denmanlab/electric_stim_gui/images/BRAINSBoard_Top_Profile_edited 4.27.39 PM.png

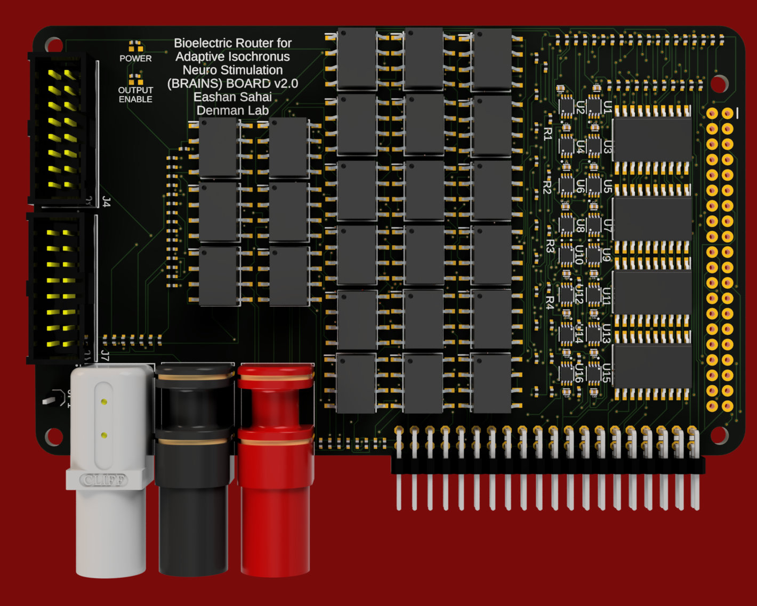
images/BRAINSBoard_Top_Profile_edited 4.27.39 PM.png
