denmanlab/electric_stim_gui/files/BRAINSBoard Production/BRAINSBoard_BOM.xlsx

Comment | Designator | Footprint
1K | R1, R2, R3, R4, R6, R7, R8, R9, R10, R11, R12, R13, R14, R15, R16, R17, R18, R19, R20, R21, R22, R23, R24, R25, R26, R27, R28, R29, R30, R31, R32, R33, R34, R35, R36, R37, R38, R39, R40, R41, R42, R43, R44, R45, R46, R47, R48, R49, R50, R51, R52, R53, R54, R55, R56, R57, R58, R59, R60, R61, R62, R63, R64, R65, R66, R67, R68, R69, R70, R71, R72, R73, R74, R75, R76, R77, R78, R79, R80, R81, R82, R83, R84, R85, R86, R87 | RC0402JR-071KL
73099-0 | J5 | 730990
73099-2 | J6 | 730990
CL05A104KA5NNNC | C1, C2, C3, C4, C5, C6, C7, C8, C9, C10, C11, C12, C13, C14, C15, C16 | CAPC1005X55N
PAA193STR | IC5, IC6, IC7, IC8, IC9, IC10, IC11, IC12, IC13, IC14, IC15, IC16, IC17, IC18, IC19, IC20, IC21, IC22, IC23, IC24, IC25, IC26, IC27, IC28 | SOP254P952X457-8N
PINHD-1X1 | JP1 | 1X01
2-215307-0 | J3 | 2X20
CY74FCT373TSOC | IC1, IC2, IC3, IC4 | SOIC127P1030X265-20N
TS5A3357DCUR | U1, U2, U3, U4, U5, U6, U7, U8, U9, U10, U11, U12, U13, U14, U15, U16 | SOP50P310X90-8N
TSS-108-01-G-D-LL | J4, J7 | SAMTEC_TSS-108-01-G-D-LL
4654-FCR7350G-ND | J2 | CONN_FCR7350G_CLF
LTST-C191KGKT | OUTPUT ENABLE | 0603 SMD/LED_LTST-C190CKT_LTO
LTST-C191KRKT | POWER | 0603 SMD/LED_LTST-C190CKT_LTO
2011-2X20G00RB | JP4 | 2X20/90
