denmanlab/electric_stim_gui/(commit log)

2024-04-17 Added the initial files that I believe are functional for STG5 and Brainsboard. Try.c is for arduino, rest_api.py is for raspberry pi. Newest and best stimulator gui is STG5_Gui_With_Channels_Extende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
2024-04-18 added some images and files that are related to the board
    [PCB_Rasp_Board.brd, Schematic.sch]
2024-04-18 added some more images and files to help with documentation
    [BRAINSBoard_BOM.xlsx, PCB_Rasp_Board.brd, Schematic.sch]
2024-05-13 Added the arduino code to control the brainsboard
2024-05-13 Added Arduino Control Section
2024-07-11 best setup 7/11/2024
    fixed issues based on readings
    [brainsboard_serial_pgm.ino]
