denmanlab/electric_stim_gui/(notices)

Notices in the files:
parts and their libraries:
SparkFun-Connectors-Local: Licensing: Creative Commons ShareAlike 4.0 International - https://creativecommons.org/licenses/by-sa/4.0
RC0402N_YAG_Local: COPYRIGHT: Copyright (C) 2023 Ultra Librarian. All rights reserved.
FCR7350G: COPYRIGHT: Copyright (C) 2024 Ultra Librarian. All rights reserved.
